takashi-kubo/DataLogger/PCB/DataLogger.step

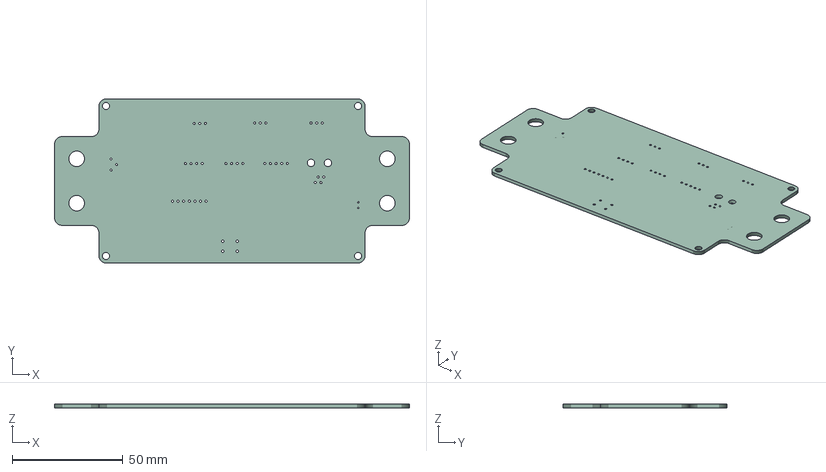
[picture p1: CAD file, 2023-10-23, last stored version]
PCB/DataLogger.step
160.0 x 74.0 x 1.58 mm
