takashi-kubo/DataLogger/(list of files, drawings)

Other design files:
PCB/DataLogger.dsn
