takashi-kubo/DataLogger/PCB/DataLogger.kicad_pcb

## KiCad design PCB/DataLogger.kicad_pcb (2023-10-23, last stored version)

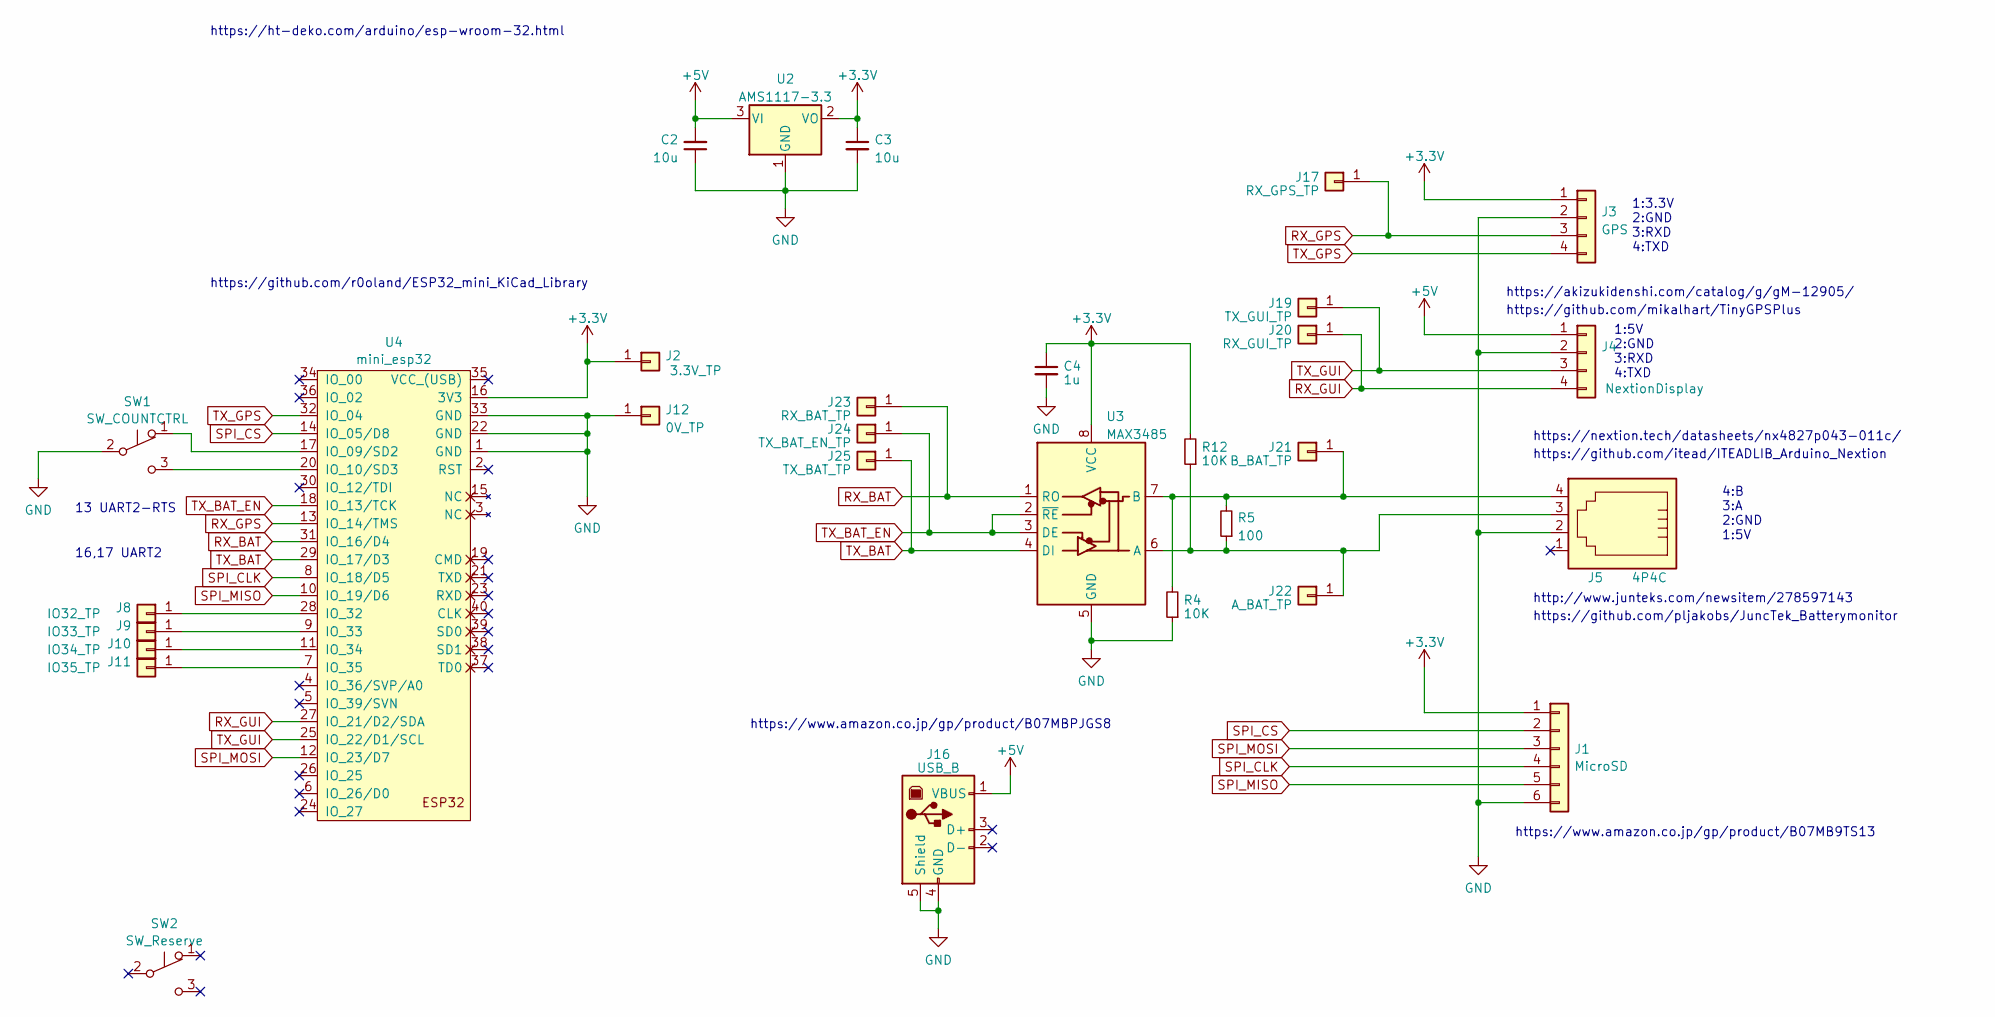
[picture p2: schematic DataLogger.kicad_sch]

Parts:
C2, C3: 10u; C_0603_1608Metric_Pad1.08x0.95mm_HandSolder
C4: 1u; C_0603_1608Metric_Pad1.08x0.95mm_HandSolder
J1: MicroSD; PinHeader_1x06_P2.54mm_Vertical
J2: 3.3V_TP; TestPoint_Pad_2.0x2.0mm
J3: GPS; JST_XH_B4B-XH-A_1x04_P2.50mm_Vertical
J4: NextionDisplay; JST_XH_B4B-XH-A_1x04_P2.50mm_Vertical
J5: 4P4C; 1-1705949-1
J8: IO32_TP; TestPoint_Pad_2.0x2.0mm
J9: IO33_TP; TestPoint_Pad_2.0x2.0mm
J10: IO34_TP; TestPoint_Pad_2.0x2.0mm
J11: IO35_TP; TestPoint_Pad_2.0x2.0mm
J12: 0V_TP; TestPoint_Pad_2.0x2.0mm
J16: USB_B; USB_B_TE_5787834_Vertical
J17: RX_GPS_TP; TestPoint_Pad_2.0x2.0mm
J19: TX_GUI_TP; TestPoint_Pad_2.0x2.0mm
J20: RX_GUI_TP; TestPoint_Pad_2.0x2.0mm
J21: B_BAT_TP; TestPoint_Pad_2.0x2.0mm
J22: A_BAT_TP; TestPoint_Pad_2.0x2.0mm
J23: RX_BAT_TP; TestPoint_Pad_2.0x2.0mm
J24: TX_BAT_EN_TP; TestPoint_Pad_2.0x2.0mm
J25: TX_BAT_TP; TestPoint_Pad_2.0x2.0mm
R4, R12: 10K; R_0603_1608Metric_Pad0.98x0.95mm_HandSolder
R5: 100; R_0603_1608Metric_Pad0.98x0.95mm_HandSolder
SW1: SW_COUNTCTRL; PinHeader_1x03_P2.54mm_Horizontal
SW2: SW_Reserve; PinHeader_1x03_P2.54mm_Horizontal
U2: AMS1117-3.3; SOT-223-3_TabPin2
U3: MAX3485; SOP-8_3.9x4.9mm_P1.27mm
U4: mini_esp32; ESP32_mini

Connections:
+3V3: C3.1, C4.1, J1.1, J2.1, J3.1, R12.2, U2.2 (VO), U3.8 (VCC), U4.16 (3V3)
+5V: C2.2, J4.1, J16.1 (VBUS), U2.3 (VI)
GND: C2.1, C3.2, C4.2, J1.6, J3.2, J4.2, J5.2, J12.1, J16.4 (GND), J16.5 (Shield), R4.1, SW1.2 (B), U2.1 (GND), U3.5 (GND), U4.1 (GND), U4.22 (GND), U4.33 (GND)
unnamed: J8.1, U4.28 (IO_32)
unnamed: J9.1, U4.9 (IO_33)
unnamed: J10.1, U4.11 (IO_34)
unnamed: J11.1, U4.7 (IO_35)
unnamed: J5.4, J21.1, R4.2, R5.2, U3.7 (B)
unnamed: J5.3, J22.1, R5.1, R12.1, U3.6 (A)
unnamed: SW1.1 (A), U4.17 (IO_09/SD2)
unnamed: SW1.3 (C), U4.20 (IO_10/SD3)
RX_BAT: J23.1, U3.1 (RO), U4.31 (IO_16/D4)
RX_GPS: J3.3, J17.1, U4.13 (IO_14/TMS)
RX_GUI: J4.4, J20.1, U4.27 (IO_21/D2/SDA)
SPI_CLK: J1.4, U4.8 (IO_18/D5)
SPI_CS: J1.2, U4.14 (IO_05/D8)
SPI_MISO: J1.5, U4.10 (IO_19/D6)
SPI_MOSI: J1.3, U4.12 (IO_23/D7)
TX_BAT: J25.1, U3.4 (DI), U4.29 (IO_17/D3)
TX_BAT_EN: J24.1, U3.2 (~RE), U3.3 (DE), U4.18 (IO_13/TCK)
TX_GPS: J3.4, U4.32 (IO_04)
TX_GUI: J4.3, J19.1, U4.25 (IO_22/D1/SCL)

Notes on the sheet:
https://www.amazon.co.jp/gp/product/B07MBPJGS8
https://github.com/pljakobs/JuncTek_Batterymonitor
1:3.3V 2:GND 3:RXD 4:TXD
https://www.amazon.co.jp/gp/product/B07MB9TS13
https://github.com/r0oland/ESP32_mini_KiCad_Library
http://www.junteks.com/newsitem/278597143
16,17 UART2
https://nextion.tech/datasheets/nx4827p043-011c/
https://github.com/itead/ITEADLIB_Arduino_Nextion
https://akizukidenshi.com/catalog/g/gM-12905/
https://ht-deko.com/arduino/esp-wroom-32.html
4:B 3:A 2:GND 1:5V
https://github.com/mikalhart/TinyGPSPlus
1:5V 2:GND 3:RXD 4:TXD
13 UART2-RTS

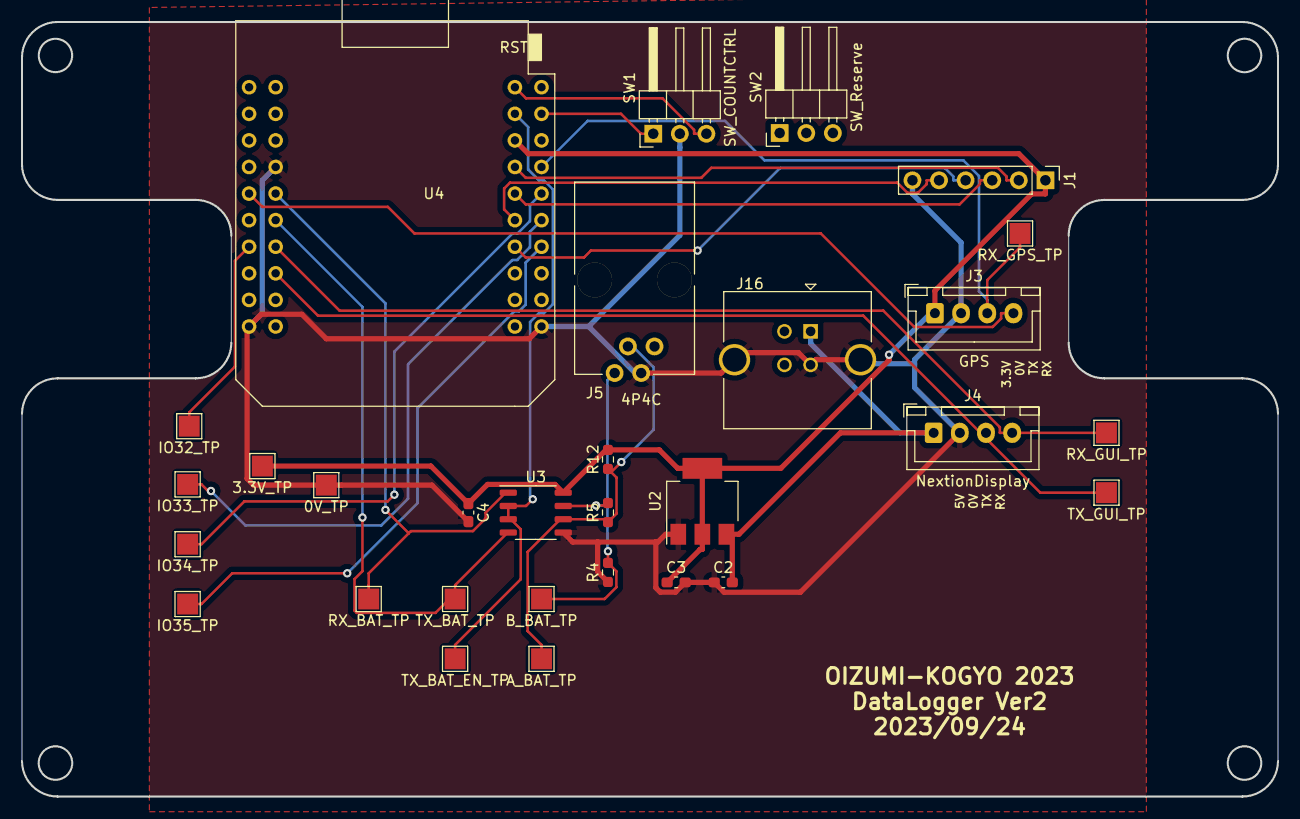
[picture p3: board DataLogger.kicad_pcb from above]

Board: 2 copper layers, 120.0 x 74.0 mm, 30 parts (0 on the bottom side), 22 nets.
