takashi-kubo/DataLogger/src/main.cpp

#include <Arduino.h>
#include <SoftwareSerial.h>
#include <TinyGPSPlus.h>
#include <HardwareSerial.h>
#include <Nextion.h>
#include <JuncTek_BatteryMonitor.h>
// #include "dischargeCurveForWEM.h"
#include "dischargeCurveNiMH.h"
#include <SD.h>
// #include <VescUart.h>
// #define nexSerial uart_DISP

//Display
// SoftwareSerial uart_DISP(21, 22); // RX, TX
HardwareSerial uart_DISP(2);
NexText DispGSpeed = NexText(1,12,"SPD");    //GPS Speed
NexText DispETime = NexText(1,13,"ETIME");     //Elapsed Time
NexText DispVoltage = NexText(1,14,"BV");   //Voltage
NexText DispCurrent = NexText(1,15,"BA");   //Current
NexText DispPower = NexText(1,16,"BP");     //Power
NexText DispICurrent = NexText(1,17,"AH");    //IntegratedCurrent
NexText DispGPSTime = NexText(1,19,"TIME");       //GPSTime
NexGauge DispPace = NexGauge(1,2,"PACE");
NexText DispIM05V = NexText(1,20,"IM05V");
NexText DispIP05V = NexText(1,21,"IP05V");



//BatteryMonitor
//TODO use hardwareserial and change connection
// SoftwareSerial uart_BATT(16, 17); // RX, TX
// HardwareSerial uart_BATT(1);
// uint8_t TX_BAT_EN = 13;
BatteryMonitor bm;

//GPS
SoftwareSerial uart_GPS(14);  //RxOnly
// HardwareSerial uart_GPS(1);
TinyGPSPlus gps;

//VESC
// VescUart vesc;
// SoftwareSerial uart_VESC(26,27);

//SD
int fileName = 0;
char fineNameCHR[16];
File file;
char fileHeader[] = {"Time,Etime,Latitude,Longitude,Altitude,Direction,Speed,IdealVoltage,Voltage,Current,Power,DischargeCapacity"};
bool enableRecord = false;

//DischargeArrayLength
int CurveLen = sizeof(idealCurve)/sizeof(double);

void setup(){
  //DebugConsole
  Serial.begin(9600);

  //Display Setup
  // nexSerial.begin(115200);  // Display
  nexSerial.begin(115200,SERIAL_8N1,21,22); //Use HardwareSerial for noise reduction

  //BatteryMonitor Setup
  // uart_BATT.setTransmitEnablePin(13);
  // uart_BATT.begin(115200); // BatteryMonitor SerialPort
  // bm.begin(1,uart_BATT);
  Serial1.setPins(16,17);
  // RS485 uart_RS485(&Serial1,13);
  Serial1.begin(115200);
  // bm.begin(1,uart_RS485);
  bm.begin(1,Serial1);
  bm.setCacheTime(10);
  pinMode(TX_BAT_EN,OUTPUT);

// Need to add inJunkTek_BatteryMonitor.cpp:sendMessage()
// Before: bm_serial->print(message);　
// After:	digitalWrite(TX_BAT_EN,HIGH); //Enable RX mode
// 		bm_serial->print(message);
// 		bm_serial->flush();
// 		digitalWrite(TX_BAT_EN,LOW); //Disable RX mode
  
  //VESC SetUP
  /** Setup SoftwareSerial port */
  // vescSerial.begin(19200);
  /** Define which ports to use as UART */
  // vesc.setSerialPort(&vescSerial);

  //SD Setup
  if(SD.begin()){
    for(fileName = 0; fileName < 100;fileName++){
      sprintf(fineNameCHR,"/%d.csv",fileName);
      if(!SD.exists(fineNameCHR))break;
    }
    // Serial.printf("FILE:%s",fineNameCHR);
    file = SD.open(fineNameCHR,FILE_WRITE);
    if(file){
      enableRecord = true;
      file.println(fileHeader);
      file.close();
    }
    else{
      // Serial.printf("ERROR File Open");
    }
  }
 
  //GPS Setup
  //Connection 赤色=VCC、黒色=GND、橙色=TXD、緑色=RXD、茶色=1pps
  // uart_GPS.begin(9600,SERIAL_8N1,14,4);
  uart_GPS.begin(9600); // GPS SerialPort

  //Switch Setup
  //IO10 Both PullUP
  pinMode(10,INPUT_PULLUP);

}


double IntCurrent = 0.0f;
int ElapsedTime = 0;


void loop(){
  char bufTime[16];
  char bufETime[16];
  char bufSpeed[16];
  char bufBattV[16];
  char bufBattA[16];
  char bufBattP[16];
  char bufBattIA[16];
  char bufIM05V[16];
  char bufIP05V[16];
  double im05v,ip05v;
  double BattVoltage = 0.0f;
  double BattCurrent = 0.0f;

  long time_Start = millis();

  //GPS
  bool gpsUpdated = false;
  while (gpsUpdated == false){
      while(uart_GPS.available() > 0 ){
        char c = uart_GPS.read();
        // Serial.print(c);
        gps.encode(c);
        gpsUpdated = gps.time.isUpdated();
      }
  }

  long time_gps = millis();

  //VESC

  //BatteryMonitor
  // uart_BATT.listen();

  //115200bpsのSoftwareSerialのため文字化けが頻発する
  // int BM_AverageValue = 16;
  // int BM_VoltageFailure = 0;
  // for(int i=0; i<BM_AverageValue;i++){
  //   if(1.0 < bm.getVoltage())
  //     BattVoltage += bm.getVoltage();
  //   else
  //     BM_VoltageFailure++;
  //   BattCurrent += bm.getCurrent();
  //   // delay(10);
  // }
  //   BattVoltage /= (double)(BM_AverageValue - BM_VoltageFailure);
  //   BattCurrent /= (double)BM_AverageValue;

  BattVoltage = bm.getVoltage();
  BattCurrent = bm.getCurrent();

  //ボツ案:取れない
  // double tempval = bm.getVoltage();
  // while(1>tempval){
  //   Serial.printf("Voltage:%f\n",tempval);
  //   tempval = bm.getVoltage();
  // }
  // BattVoltage = tempval;

  // tempval = bm.getCurrent();
  // while(isnan(tempval)){
  //   tempval = bm.getCurrent();
  // }
  // BattCurrent = tempval;

  double BattPower = BattVoltage * BattCurrent;
  IntCurrent+=BattCurrent;

  long time_bm = millis();

  sprintf(bufTime,"%02d:%02d:%02d",(gps.time.hour()+9)%24,gps.time.minute(),gps.time.second());
  sprintf(bufSpeed, "%2.1f",gps.speed.kmph());
  sprintf(bufBattV,"%2.1f",BattVoltage);
  sprintf(bufBattA,"%2.2f",BattCurrent);
  sprintf(bufBattP,"%3.1f",BattPower);
  sprintf(bufBattIA,"%1.2f",IntCurrent/3600);
  sprintf(bufETime,"%02d:%02d:%02d",ElapsedTime/3600,(ElapsedTime/60)%60,ElapsedTime%60);
  im05v = idealCurve[ElapsedTime]-0.5;
  ip05v = idealCurve[ElapsedTime]+0.5;
  sprintf(bufIM05V,"%2.1fV",im05v);
  sprintf(bufIP05V,"%2.1fV",ip05v);
  double VoltDiff = BattVoltage - idealCurve[ElapsedTime];

  long time_disp_sprint = millis();
Serial.flush();
Serial1.flush();
Serial2.flush();

  // delay(10);  //delay 10ms for flush uart buffer...
  //DISPLAY
  // uart_DISP.listen();  //USE for SoftwareSerial
  DispGPSTime.setText(bufTime);
  DispGSpeed.setText(bufSpeed);
  DispVoltage.setText(bufBattV);
  DispCurrent.setText(bufBattA);
  DispPower.setText(bufBattP);
  DispICurrent.setText(bufBattIA);
  // DispETime.setText(bufETime);
  // DispIM05V.setText(bufIM05V);
  // DispIP05V.setText(bufIP05V);
  // if(BattVoltage <= im05v){
  //     DispPace.setValue(0);
  // }
  // else if(ip05v <= BattVoltage){
  //     DispPace.setValue(100);
  // }
  // else{
  //     DispPace.setValue((int)((BattVoltage - im05v) * 100));
  // }

  long time_disp = millis();

  //Write to SD
  if(enableRecord){
    file = SD.open(fineNameCHR,FILE_APPEND);
    if(file){
      char buf[256];
      sprintf(buf,"%s,%s,%f,%f,%f,%f,%s,%f,%s,%s,%s,%s",
      bufTime,bufETime,gps.location.lat(),gps.location.lng(),gps.altitude.meters(),gps.course.deg(),bufSpeed,
      idealCurve[ElapsedTime],bufBattV,bufBattA,bufBattP,bufBattIA);
      file.println(buf);
      file.close();
    }
  }

  long time_sd = millis();
  if(LOW == digitalRead(10)){
    ElapsedTime++;
    ElapsedTime %= CurveLen;
  }

  Serial.printf("GPS:%3ld,BM:%3ld,SPRINT:%3ld,DISP:%3ld,SD:%3ld\n",
  time_gps - time_Start,time_bm - time_gps,time_disp_sprint - time_bm,time_disp - time_disp_sprint,time_sd - time_disp);

  // uart_GPS.listen();
  // delay(500);
}
