takashi-kubo/DataLogger/src/dischargeCurveNiMH.h

//1時間25分 85分後に18.9VになるNi-NHカーブ
//20直1並列で1.3Aのカーブ

double idealCurve[] = {
	27.432,
	27.347,
	27.347,
	27.311,
	27.237,
	27.195,
	27.195,
	27.178,
	27.131,
	27.105,
	27.085,
	27.065,
	27.047,
	27.021,
	27.021,
	27.006,
	26.982,
	26.969,
	26.946,
	26.936,
	26.917,
	26.88,
	26.875,
	26.849,
	26.838,
	26.817,
	26.805,
	26.797,
	26.797,
	26.778,
	26.765,
	26.75,
	26.744,
	26.727,
	26.702,
	26.691,
	26.672,
	26.664,
	26.651,
	26.646,
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
};
