takashi-kubo/DataLogger/src/dischargeCurveForWEM.h

//7200秒後に20Vになる鉛蓄カーブ
//2直1並列で1.3Aくらいのカーブのはず
//7500秒まで数値アリ

double idealCurve[] = {
	26.19,
	26.03,
	25.912,
	25.716,
	25.624,
	25.54,
	25.474,
	25.3,
	25.256,
	25.222,
	25.16,
	25.136,
	25.114,
	25.064,
	25.052,
	25.042,
	25.03,
	25.016,
	25.008,
	25,
	24.996,
	24.994,
	24.992,
	24.986,
	24.986,
	24.984,
	24.986,
	24.986,
	24.986,
	24.986,
	24.988,
	24.99,
	24.992,
	24.99,
	24.996,
	24.994,
	24.996,
	24.992,
	24.994,
	24.998,
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
};
	
