takashi-kubo/DataLogger/(commit log)

2023-07-15 Modify Display Baud Rate For Noise Reduction
    [main.cpp]
2023-10-09 improvement bm monitoring and battery capacity display digit
2023-10-23 add pcb data
    [DataLogger.dsn, DataLogger.kicad_pcb, DataLogger.kicad_sch, DataLogger.step, bom.csv, designators.csv, positions.csv]
2023-10-26 PCB Data moved to new repository. new repository is Datalogger_PCB
2023-10-26 PCB data moved to new repository
    [DataLogger.dsn, DataLogger.kicad_pcb, DataLogger.kicad_sch, DataLogger.step, bom.csv, designators.csv, positions.csv]
